arjun1223/SkySafe/THIRD_PARTY_NOTICES.md

# UI component credits

SkySafe adapts two Uiverse components for its monochrome instrument interface:

- **martinval9 — white-lionfish-18**: rectangular toggle used for light/dark theme and automatic load sweep. [Uiverse original](https://uiverse.io/martinval9/white-lionfish-18), [source](https://github.com/uiverse-io/galaxy/blob/main/Toggle-switches/martinval9_white-lionfish-18.html).
- **cssbuttons-io — friendly-dragon-76**: hover/pressed movement adapted for the primary baseline button. The original pill shape and expanding halo are removed. [Uiverse original](https://uiverse.io/cssbuttons-io/friendly-dragon-76), [source](https://github.com/uiverse-io/galaxy/blob/main/Buttons/cssbuttons-io_friendly-dragon-76.html).

Changes include theme variables, keyboard focus, reduced motion support, dimensions and restrained hover effects. The original files and the Uiverse repository license are retained in `docs/uiverse/`.

Copyright (c) 2023 Uiverse.io

Copyright - 2026 martinval9

Copyright - 2026 cssbuttons-io (cssbuttons.io)

Permission is hereby granted, free of charge, to any person obtaining a copy of this software and associated documentation files (the "Software"), to deal in the Software without restriction, including without limitation the rights to use, copy, modify, merge, publish, distribute, sublicense, and/or sell copies of the Software, and to permit persons to whom the Software is furnished to do so, subject to the following conditions:

The above copyright notice and this permission notice shall be included in all copies or substantial portions of the Software.

THE SOFTWARE IS PROVIDED "AS IS", WITHOUT WARRANTY OF ANY KIND, EXPRESS OR IMPLIED, INCLUDING BUT NOT LIMITED TO THE WARRANTIES OF MERCHANTABILITY, FITNESS FOR A PARTICULAR PURPOSE AND NONINFRINGEMENT. IN NO EVENT SHALL THE AUTHORS OR COPYRIGHT HOLDERS BE LIABLE FOR ANY CLAIM, DAMAGES OR OTHER LIABILITY, WHETHER IN AN ACTION OF CONTRACT, TORT OR OTHERWISE, ARISING FROM, OUT OF OR IN CONNECTION WITH THE SOFTWARE OR THE USE OR OTHER DEALINGS IN THE SOFTWARE.

Flask, pyserial, Plotly, Arduino-ESP32, HX711 Arduino Library, and Adafruit sensor libraries retain their respective upstream licenses. They are installed dependencies, not vendored application source. Plotly JavaScript is served locally from its Python package.
