arjun1223/SkySafe/cad/fusion_laptop_stand/previews/load_cell_side_view.png

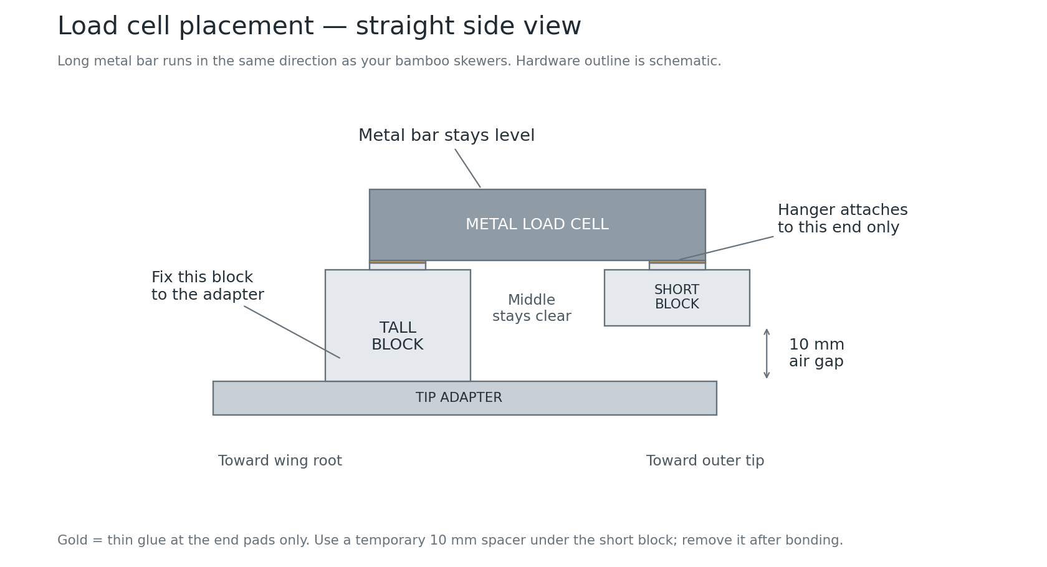
cad/fusion_laptop_stand/previews/load_cell_side_view.png
