arjun1223/SkySafe/cad/fusion_laptop_stand/previews/stand_close.png

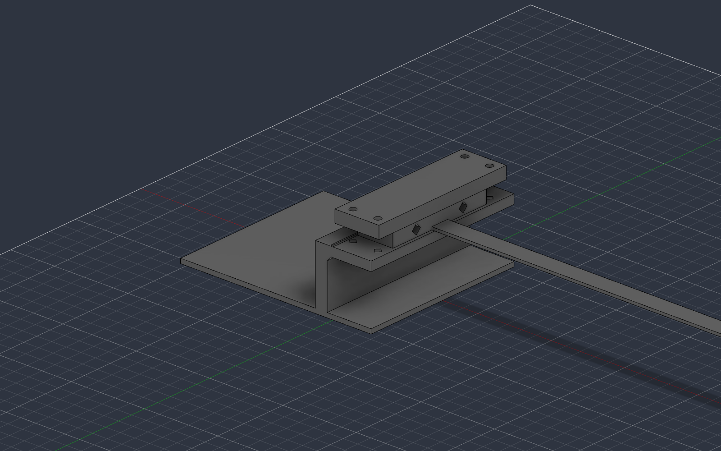
cad/fusion_laptop_stand/previews/stand_close.png
