arjun1223/SkySafe/cad/fusion_laptop_stand/previews/stand_with_wing.png

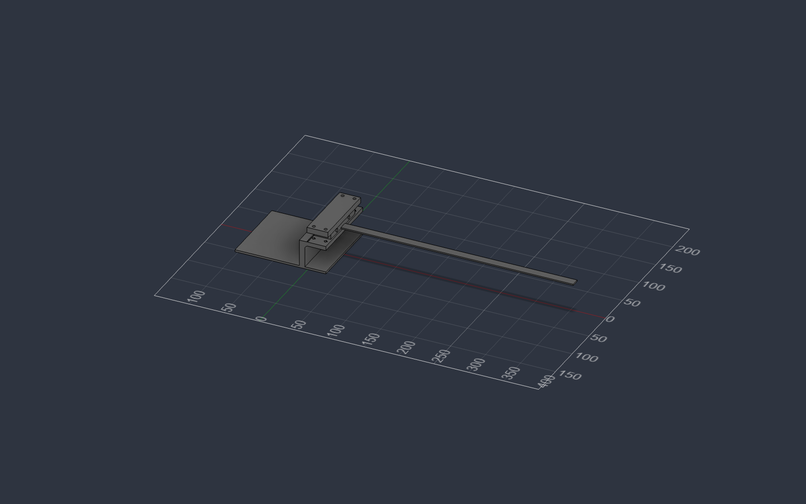
cad/fusion_laptop_stand/previews/stand_with_wing.png
