arjun1223/SkySafe/cad/fusion_laptop_stand/previews/tip_mount_detail.png

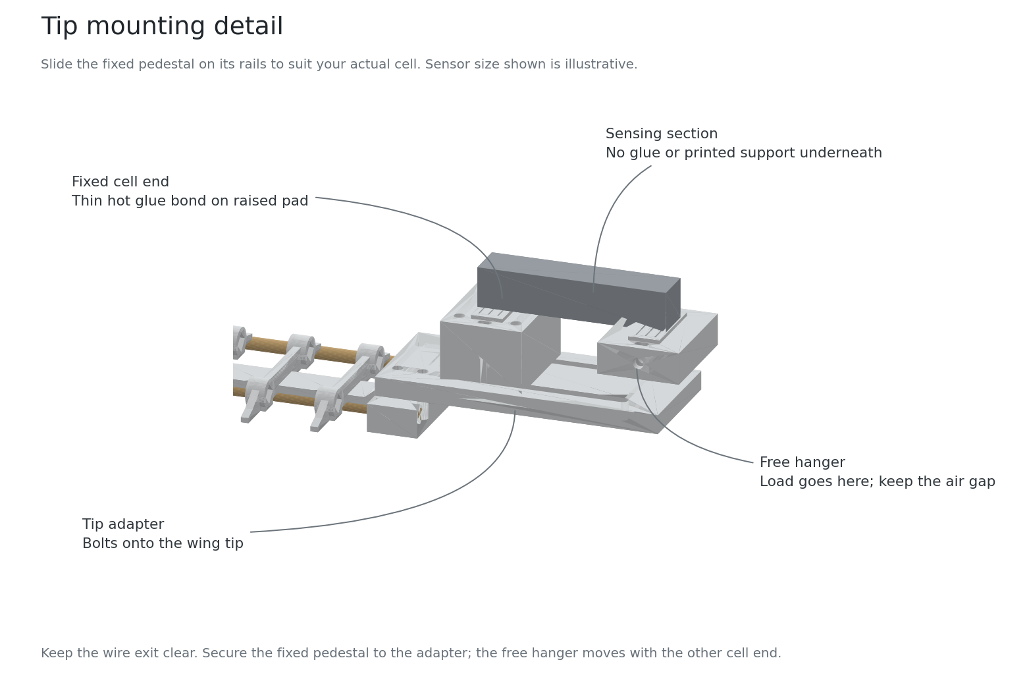
cad/fusion_laptop_stand/previews/tip_mount_detail.png
