arjun1223/SkySafe/cad/previews/exploded.png

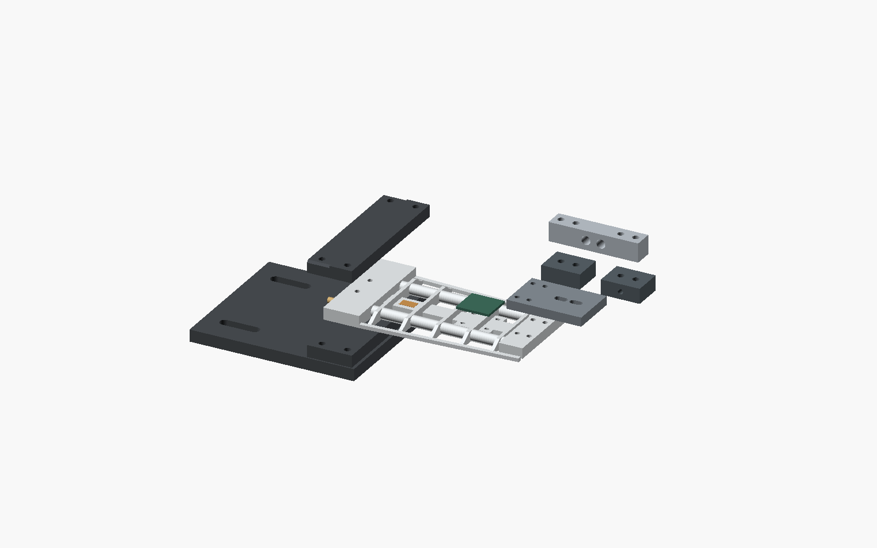
cad/previews/exploded.png
