arjun1223/SkySafe/cad/previews/spar_fit_coupon.png

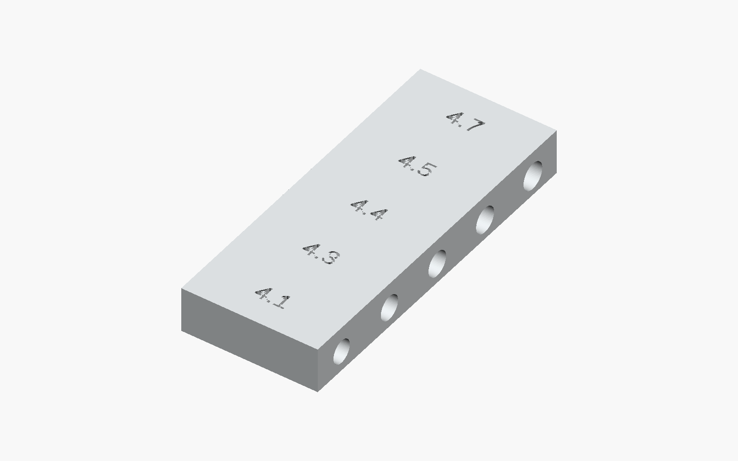
cad/previews/spar_fit_coupon.png
