arjun1223/SkySafe/cad/previews/wing.png

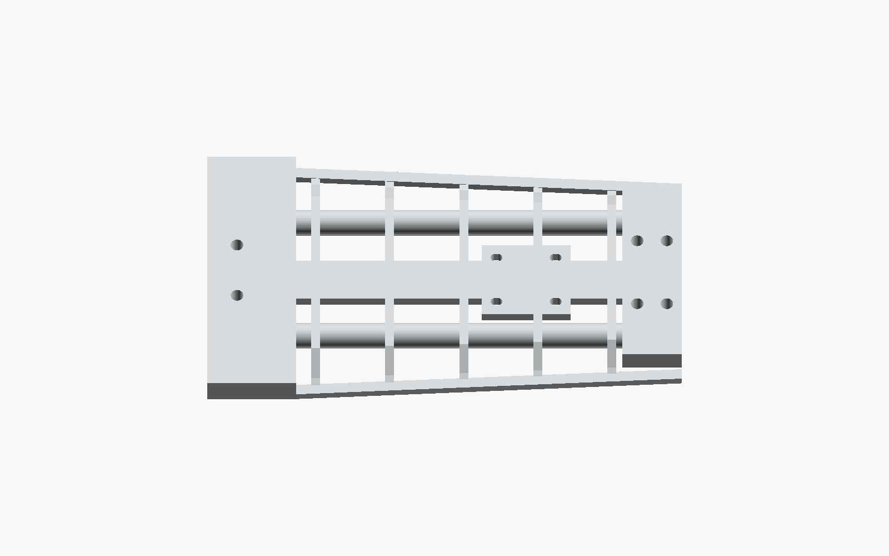
cad/previews/wing.png
