arjun1223/SkySafe/docs/dashboard-dark.png

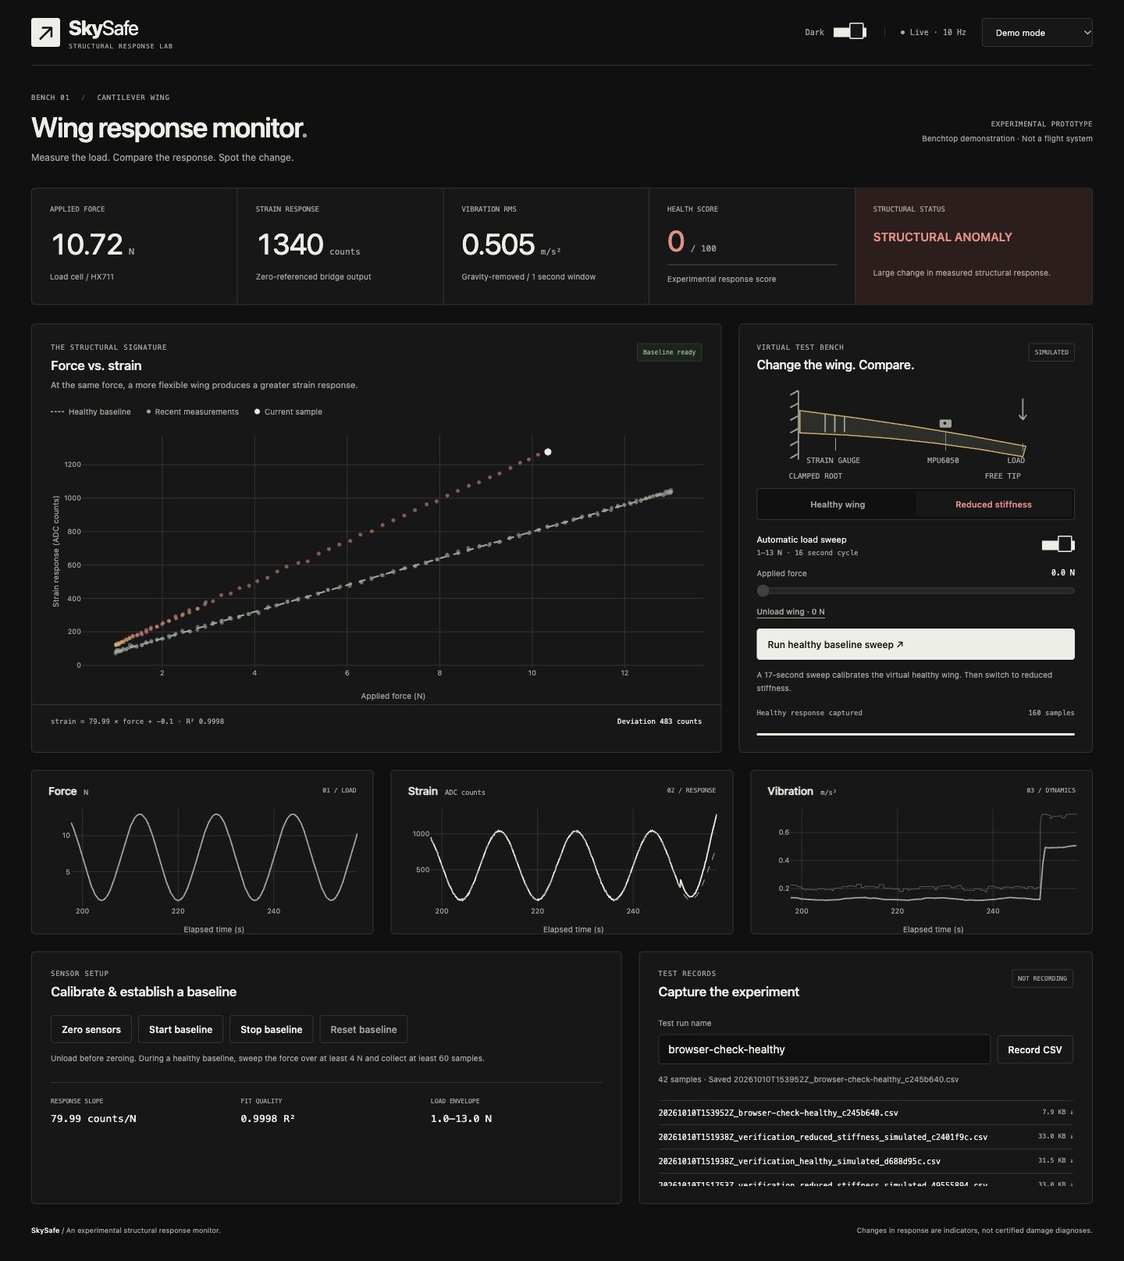
docs/dashboard-dark.png
