arjun1223/SkySafe/docs/dashboard-light.png

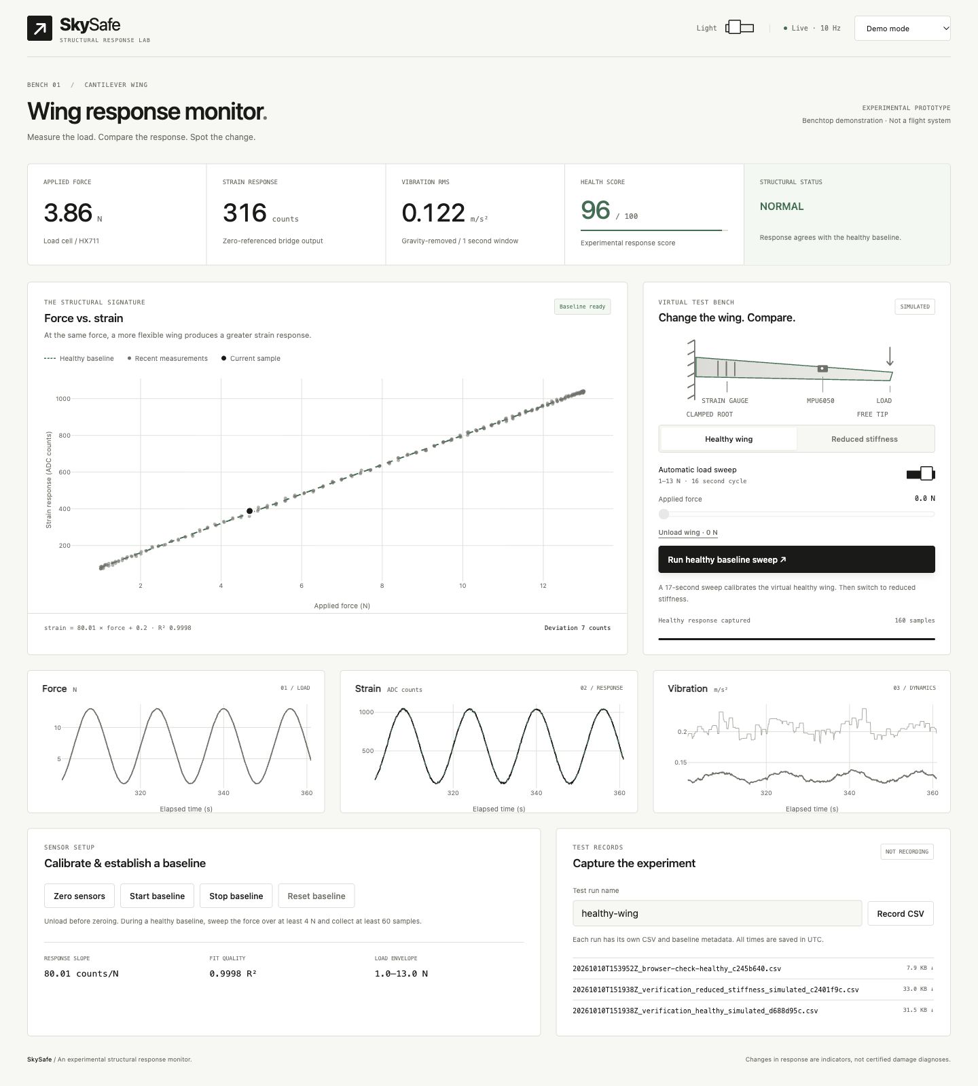
docs/dashboard-light.png
