arjun1223/SkySafe/docs/developer-mode.png

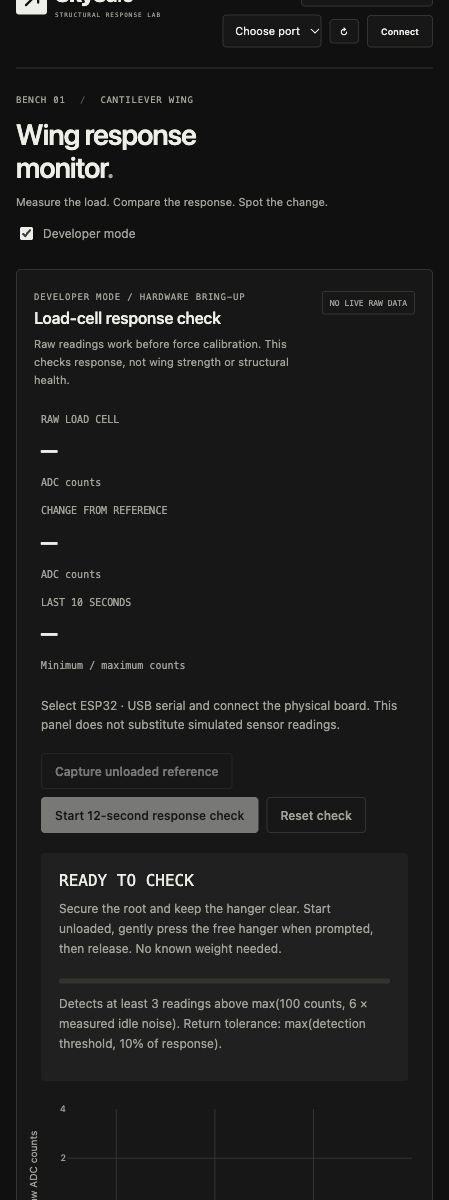
docs/developer-mode.png
