arjun1223/SkySafe/docs/judge-anomaly-dark.png

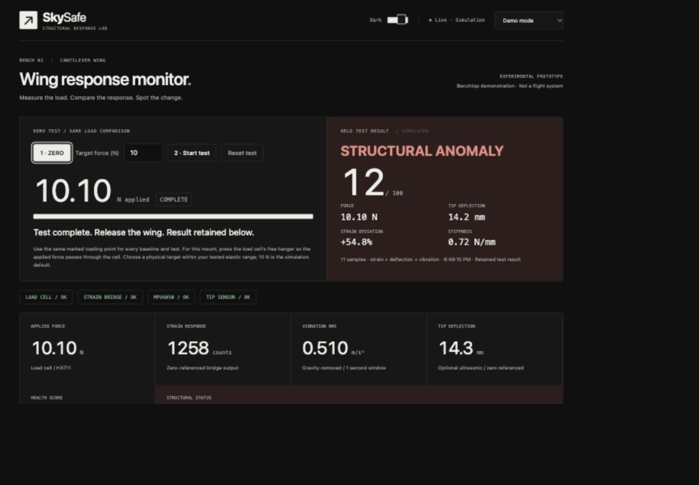
docs/judge-anomaly-dark.png
