arjun1223/SkySafe/docs/judge-healthy-light.png

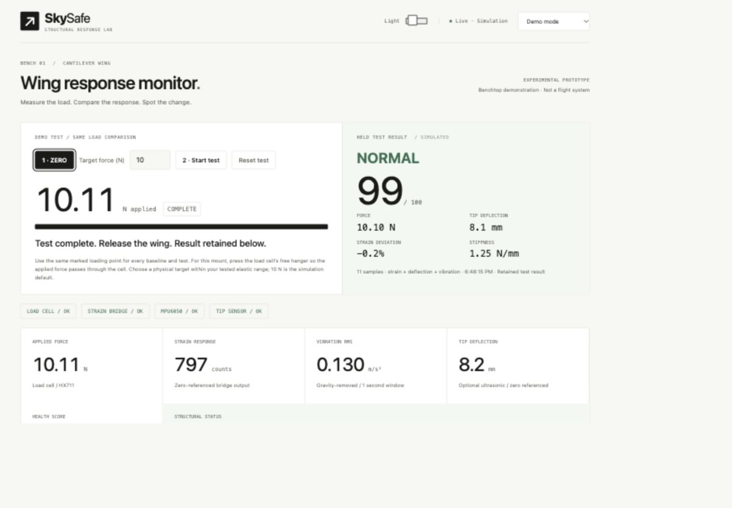
docs/judge-healthy-light.png
