arjun1223/SkySafe/docs/judge-mobile-dark.png

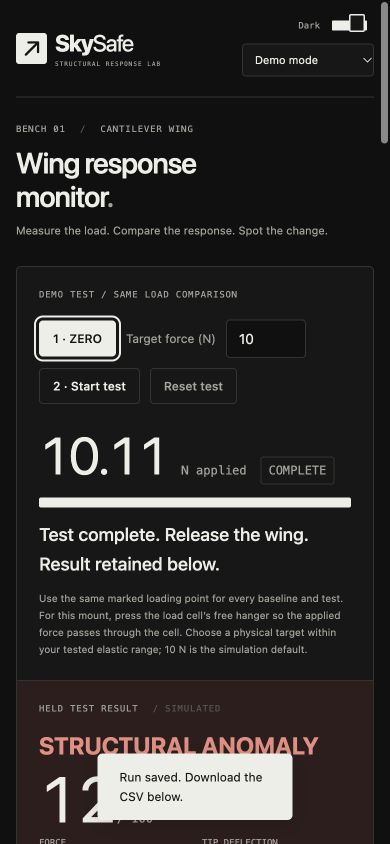
docs/judge-mobile-dark.png
