arjun1223/SkySafe/docs/live-alarm-controls.png

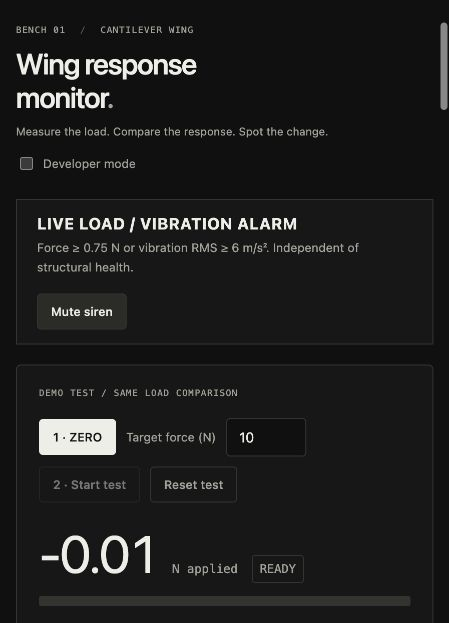
docs/live-alarm-controls.png
