arjun1223/SkySafe/docs/strain-bridge-live.png

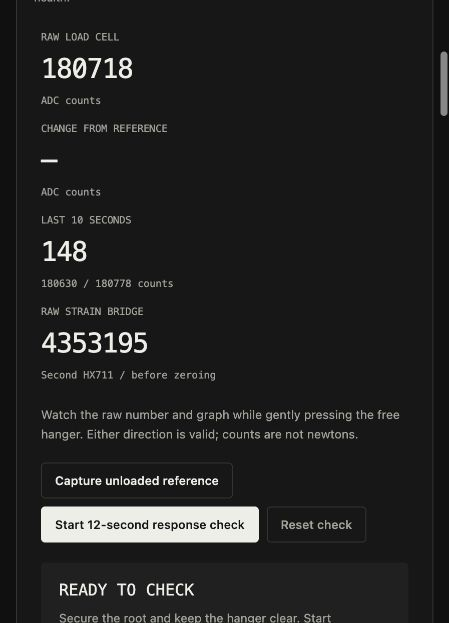
docs/strain-bridge-live.png
