arjun1223/SkySafe/cad/fusion_laptop_stand/previews/your_parts_assembly.png

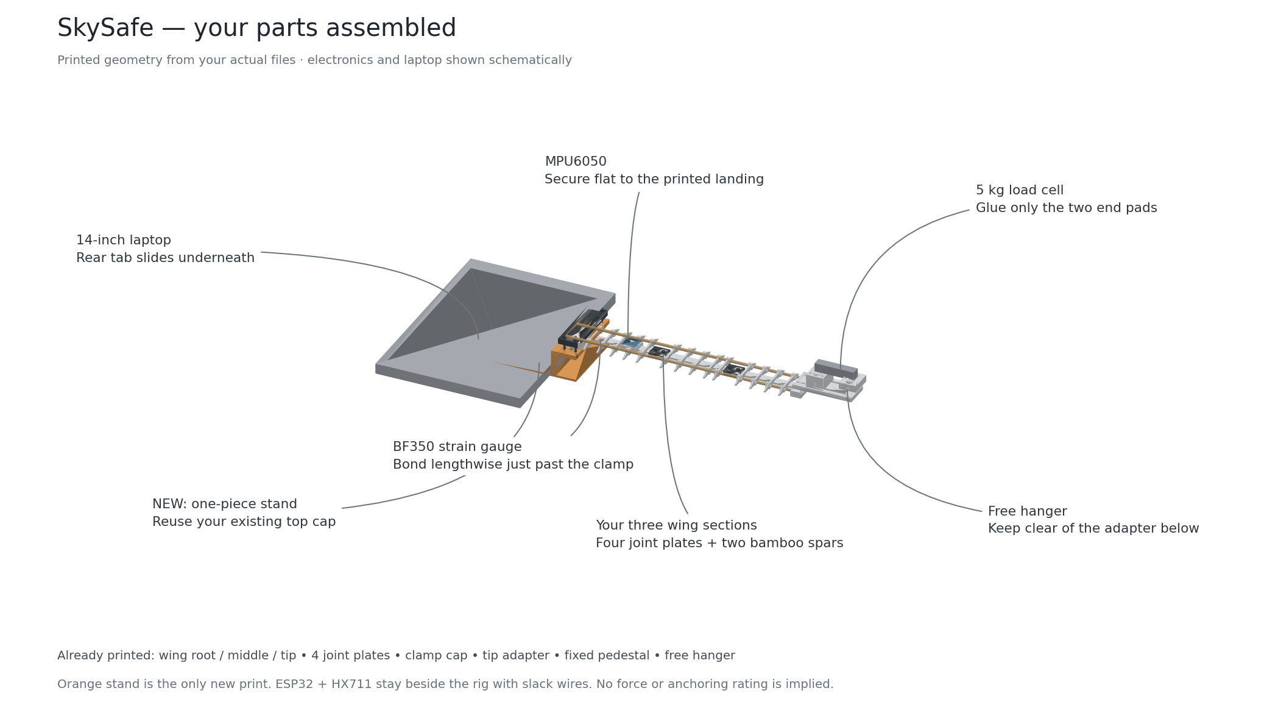
cad/fusion_laptop_stand/previews/your_parts_assembly.png
