arjun1223/SkySafe/cad/fusion/SkySafe_Assembly.step

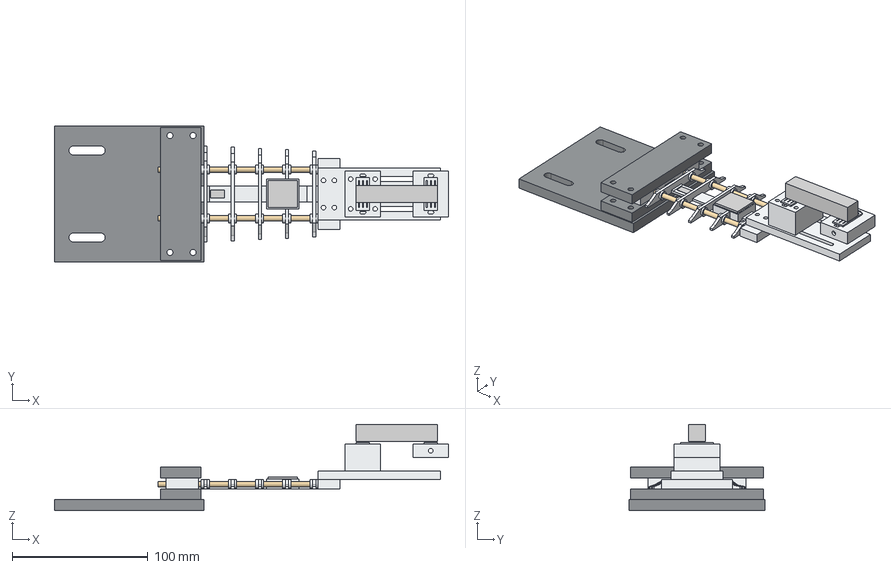
[picture p19: CAD file, 2026-10-11]
cad/fusion/SkySafe_Assembly.step
290.0 x 100.0 x 63.4 mm
