arjun1223/SkySafe/cad/fusion_14inch/SkySafe_Assembly.step

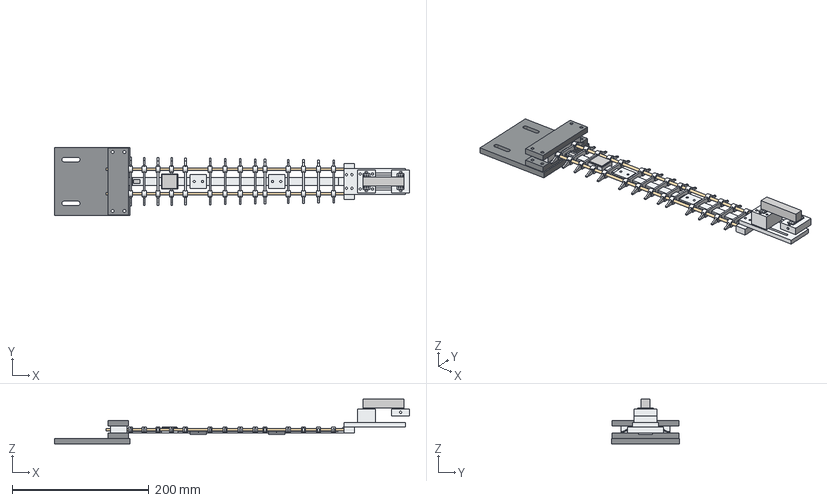
[picture p20: CAD file, 2026-10-11]
cad/fusion_14inch/SkySafe_Assembly.step
518.4 x 100.0 x 65.4 mm
