arjun1223/SkySafe/cad/fusion/step/cell_spacer.step

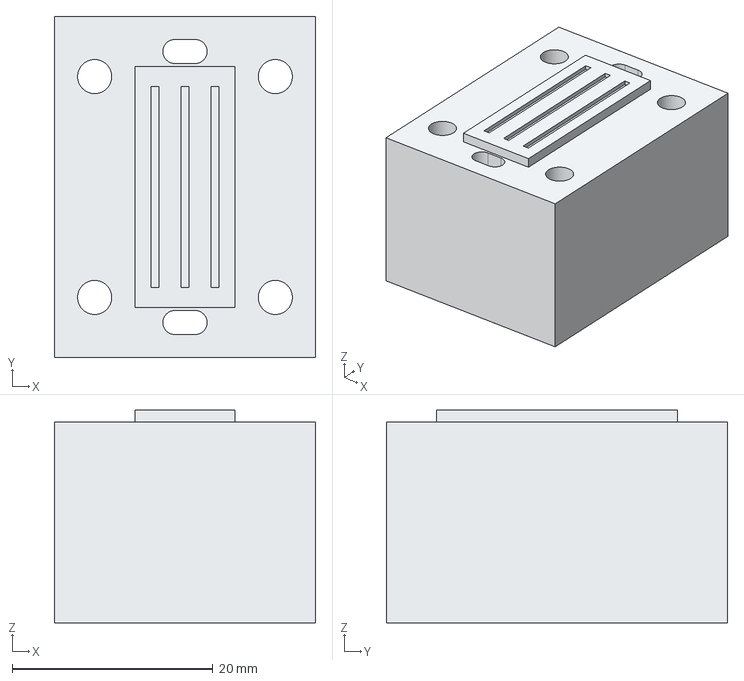
[picture p21: CAD file, 2026-10-11]
cad/fusion/step/cell_spacer.step
26.0 x 34.0 x 21.2 mm
