arjun1223/SkySafe/cad/fusion_14inch/step/spar_fit_coupon.step

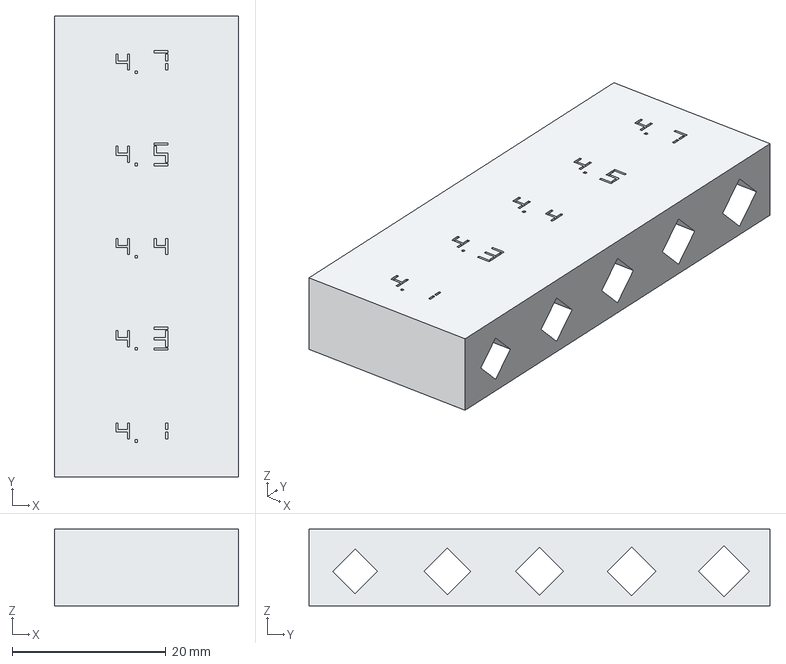
[picture p22: CAD file, 2026-10-11]
cad/fusion_14inch/step/spar_fit_coupon.step
24.0 x 60.0 x 10.0 mm
