arjun1223/SkySafe/cad/fusion_laptop_stand/SkySafe_Laptop_Stand.step

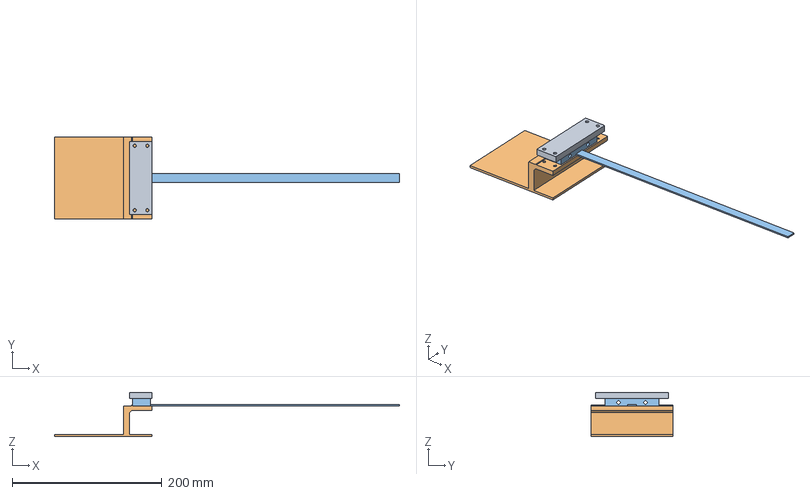
[picture p23: CAD file, 2026-10-11]
cad/fusion_laptop_stand/SkySafe_Laptop_Stand.step
460.4 x 110.0 x 59.0 mm
