arjun1223/SkySafe/cad/fusion_laptop_stand/step/laptop_foot_stand.step

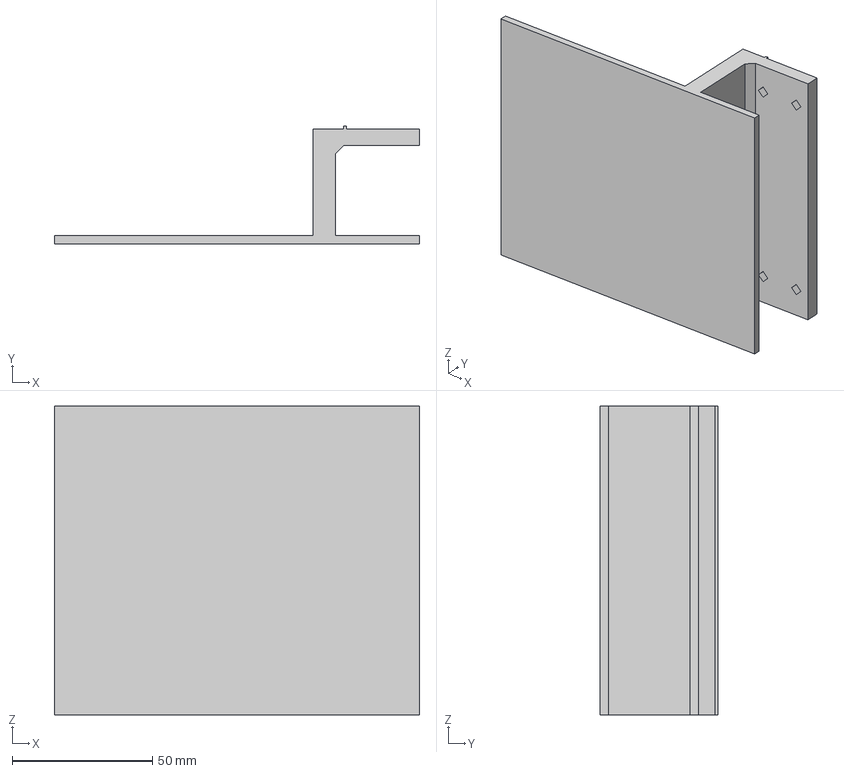
[picture p24: CAD file, 2026-10-11]
cad/fusion_laptop_stand/step/laptop_foot_stand.step
130.0 x 42.0 x 110.0 mm
