arjun1223/SkySafe/cad/fusion_weighted/SkySafe_Weighted_Holder.step

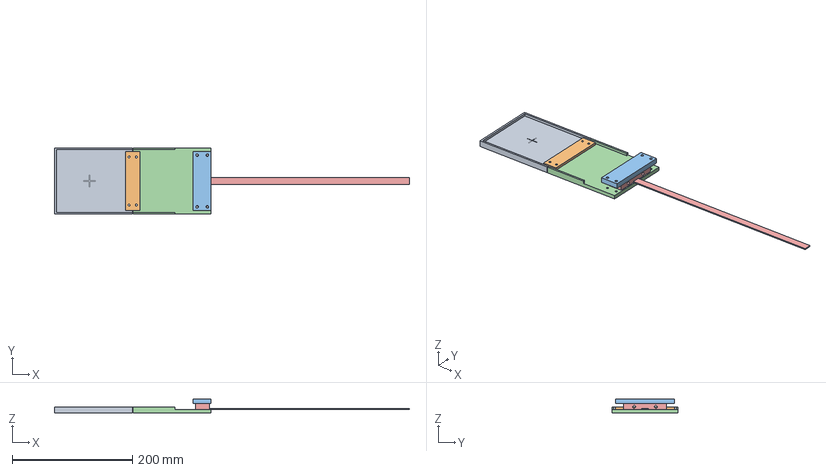
[picture p25: CAD file, 2026-10-11]
cad/fusion_weighted/SkySafe_Weighted_Holder.step
590.6 x 110.0 x 24.0 mm
