arjun1223/SkySafe/cad/fusion_weighted/step/tray_bridge.step

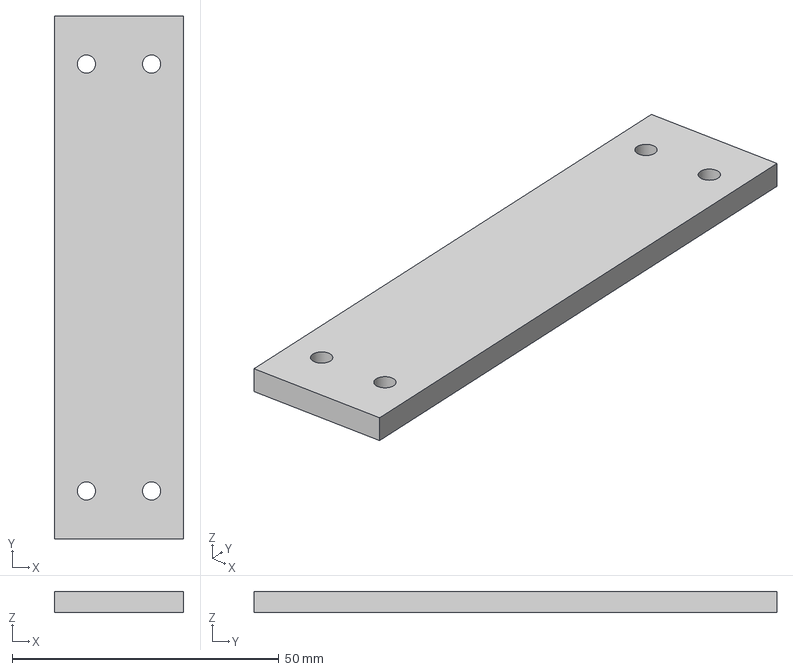
[picture p26: CAD file, 2026-10-11]
cad/fusion_weighted/step/tray_bridge.step
24.2 x 98.0 x 4.00 mm
