arjun1223/SkySafe/cad/stl/cell_spacer.stl

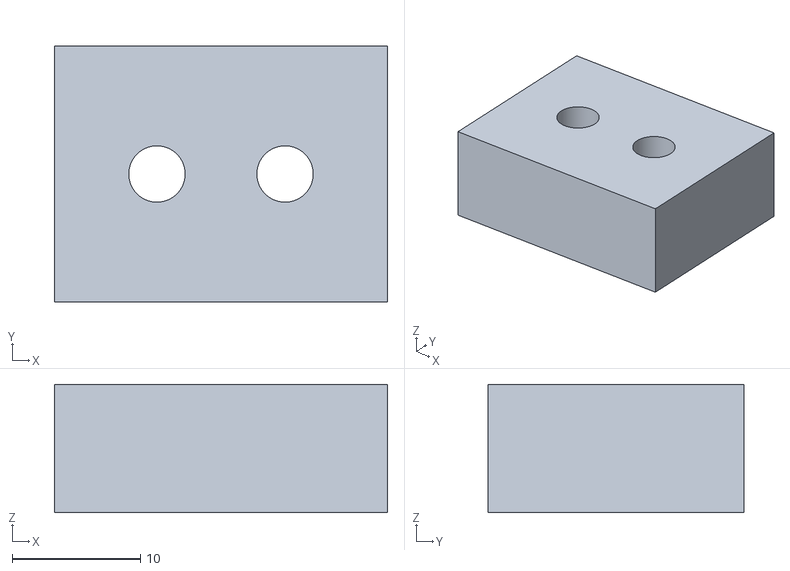
[picture p27: CAD file, 2026-10-11]
cad/stl/cell_spacer.stl
26.0 x 20.0 x 10.0
