arjun1223/SkySafe/cad/fusion/step/wing.step

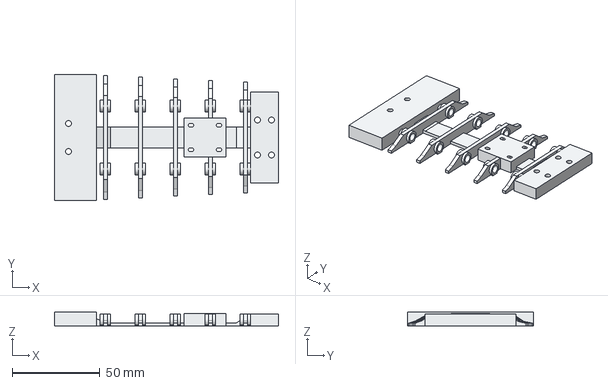
[picture p28: CAD file, 2026-10-11]
cad/fusion/step/wing.step
128.0 x 72.0 x 8.00 mm
