arjun1223/SkySafe/cad/fusion_14inch/step/root_cap.step

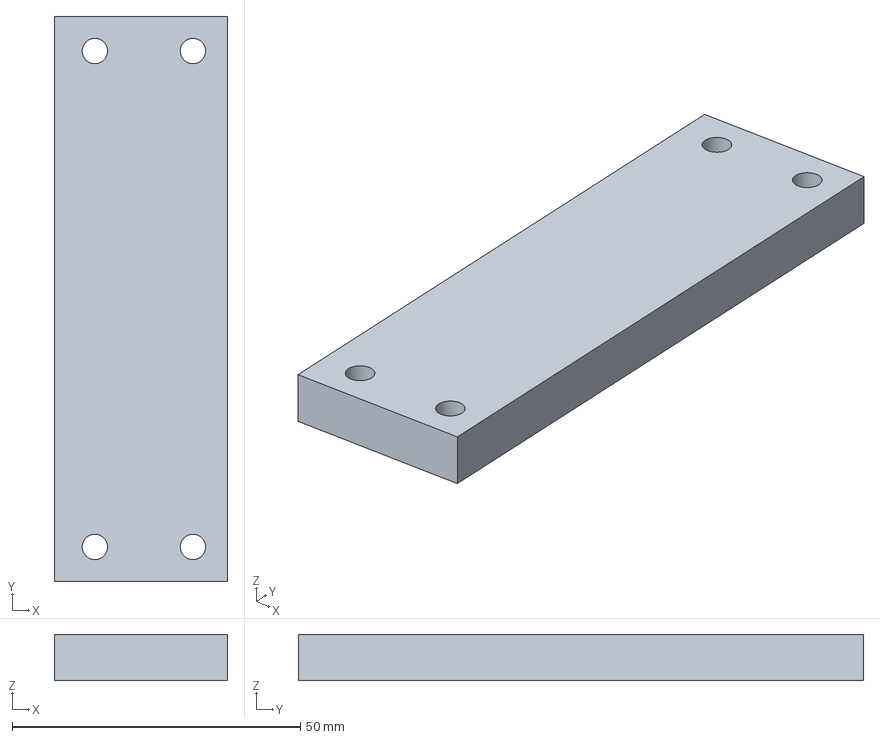
[picture p29: CAD file, 2026-10-11]
cad/fusion_14inch/step/root_cap.step
30.0 x 98.0 x 8.00 mm
