arjun1223/SkySafe/cad/fusion_weighted/step/ballast_tray.step

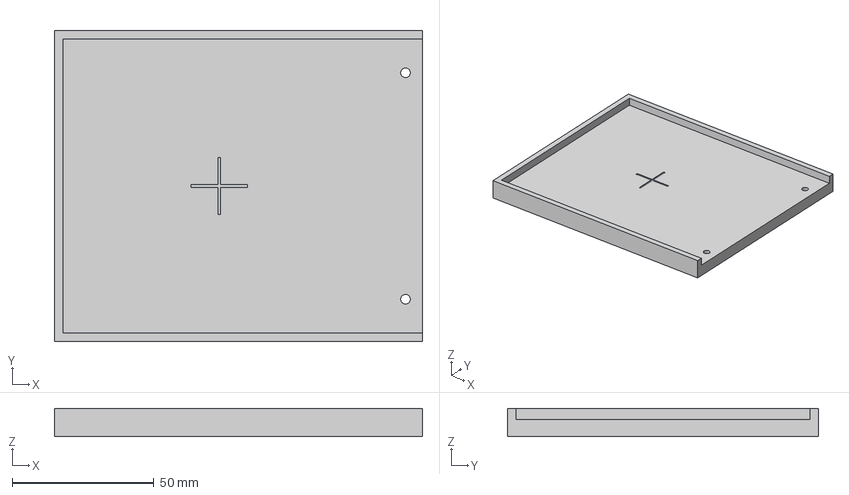
[picture p30: CAD file, 2026-10-11]
cad/fusion_weighted/step/ballast_tray.step
130.0 x 110.0 x 10.0 mm
