arjun1223/SkySafe/cad/stl/spar_fit_coupon.stl

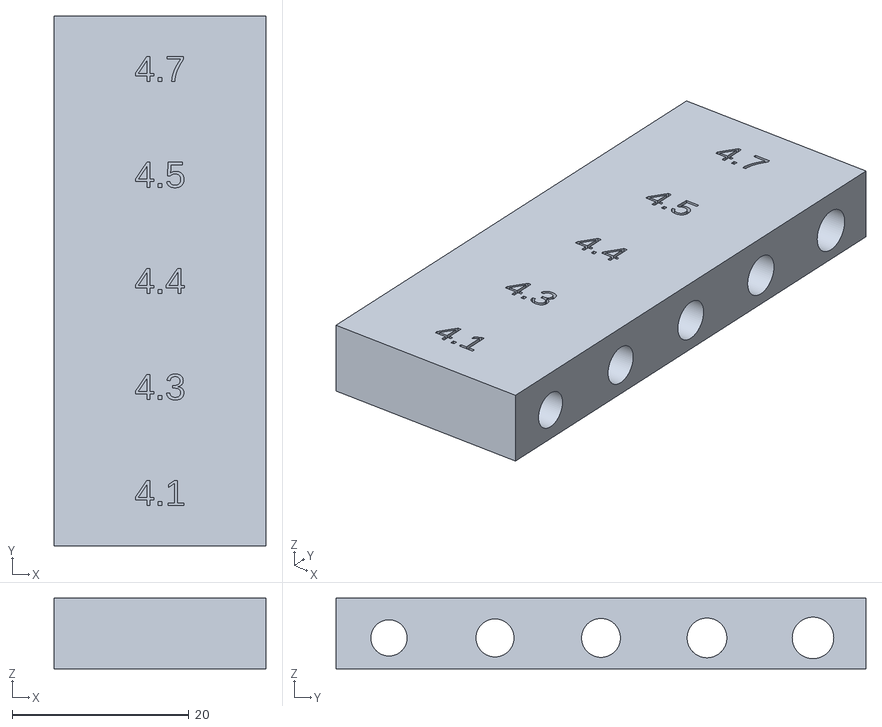
[picture p31: CAD file, 2026-10-11]
cad/stl/spar_fit_coupon.stl
24.0 x 60.0 x 8.00
