arjun1223/SkySafe/cad/fusion_14inch/step/wing_tip.step

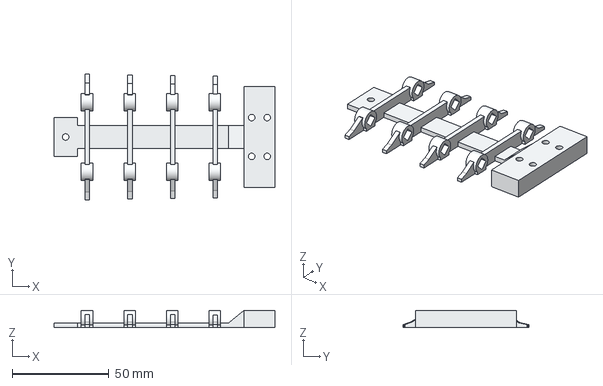
[picture p32: CAD file, 2026-10-11]
cad/fusion_14inch/step/wing_tip.step
114.0 x 64.7 x 9.00 mm
