arjun1223/SkySafe/cad/fusion_weighted/step/weighted_root_base.step

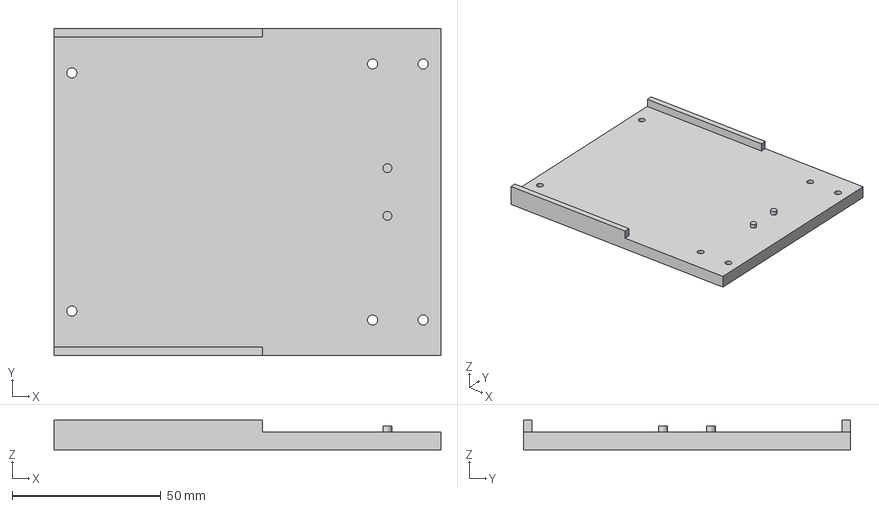
[picture p33: CAD file, 2026-10-11]
cad/fusion_weighted/step/weighted_root_base.step
130.0 x 110.0 x 10.0 mm
