arjun1223/SkySafe/cad/stl/load_hanger.stl

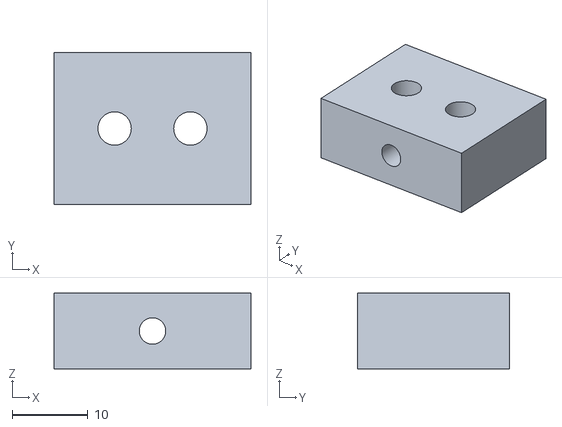
[picture p34: CAD file, 2026-10-11]
cad/stl/load_hanger.stl
26.0 x 20.0 x 10.0
