arjun1223/SkySafe/cad/fusion/step/load_hanger.step

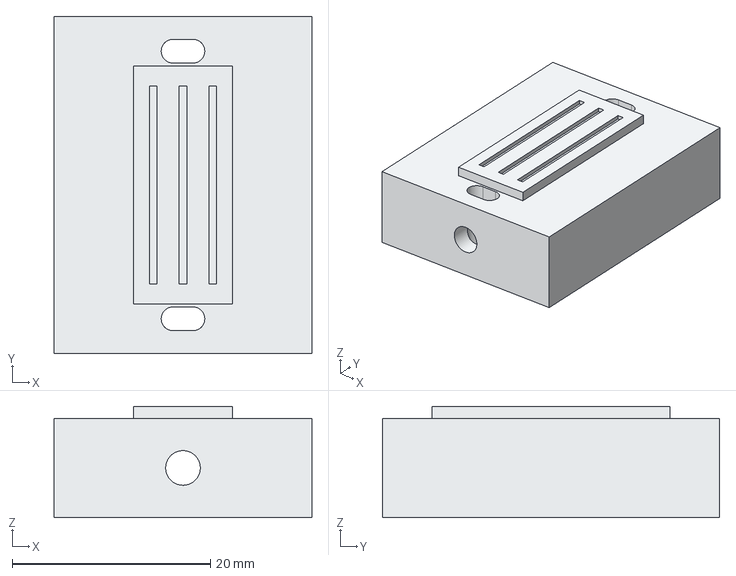
[picture p35: CAD file, 2026-10-11]
cad/fusion/step/load_hanger.step
26.0 x 34.0 x 11.2 mm
