arjun1223/SkySafe/cad/fusion_14inch/step/joint_plate.step

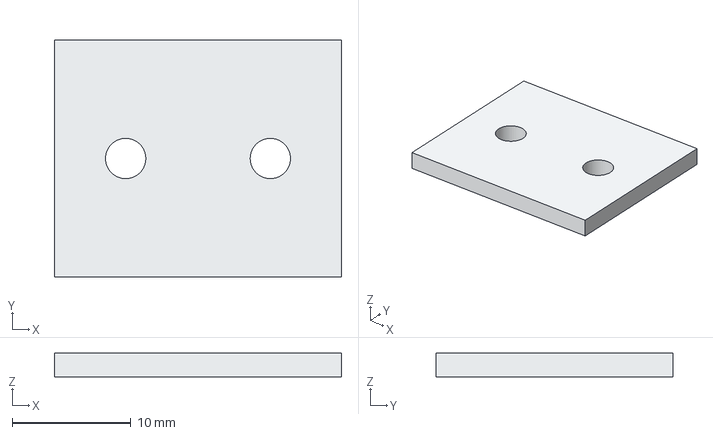
[picture p36: CAD file, 2026-10-11]
cad/fusion_14inch/step/joint_plate.step
24.2 x 20.0 x 2.00 mm
