arjun1223/SkySafe/cad/stl/tip_adapter.stl

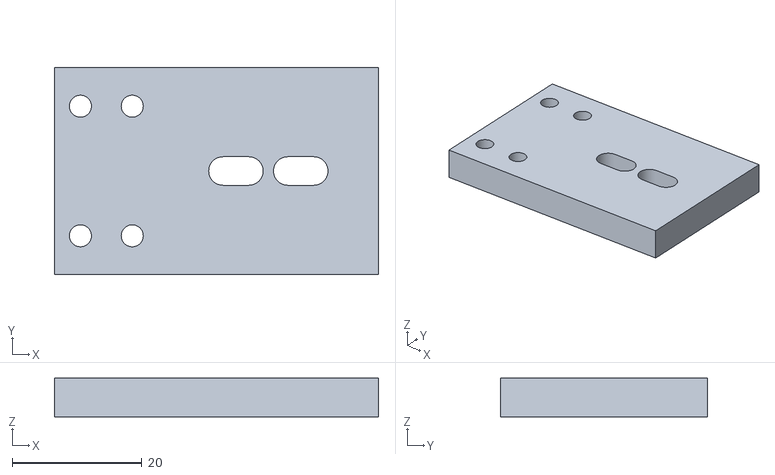
[picture p37: CAD file, 2026-10-11]
cad/stl/tip_adapter.stl
50.0 x 32.0 x 6.00
