arjun1223/SkySafe/cad/fusion/step/tip_adapter.step

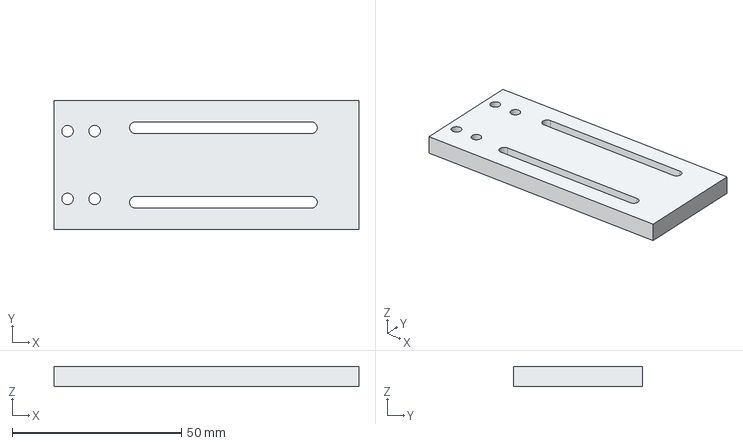
[picture p38: CAD file, 2026-10-11]
cad/fusion/step/tip_adapter.step
90.0 x 38.0 x 6.00 mm
