arjun1223/SkySafe/cad/fusion_14inch/step/wing_root.step

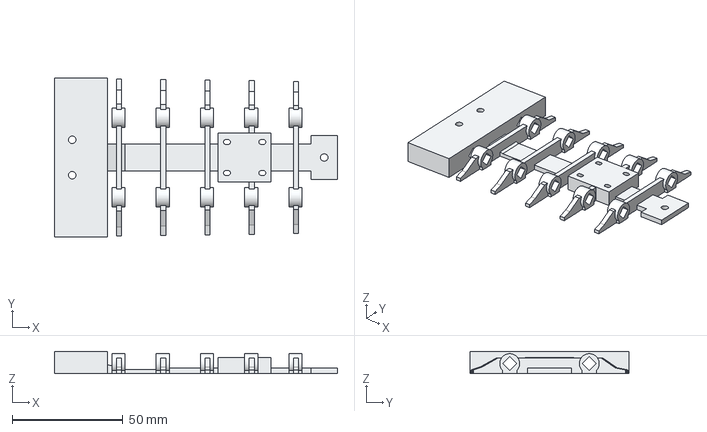
[picture p39: CAD file, 2026-10-11]
cad/fusion_14inch/step/wing_root.step
128.0 x 72.0 x 10.0 mm
