arjun1223/SkySafe/cad/stl/wing.stl

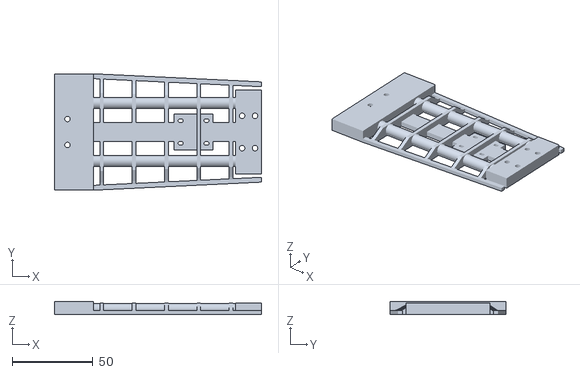
[picture p40: CAD file, 2026-10-11]
cad/stl/wing.stl
128.0 x 72.0 x 8.00
