arjun1223/SkySafe/cad/fusion/step/root_base.step

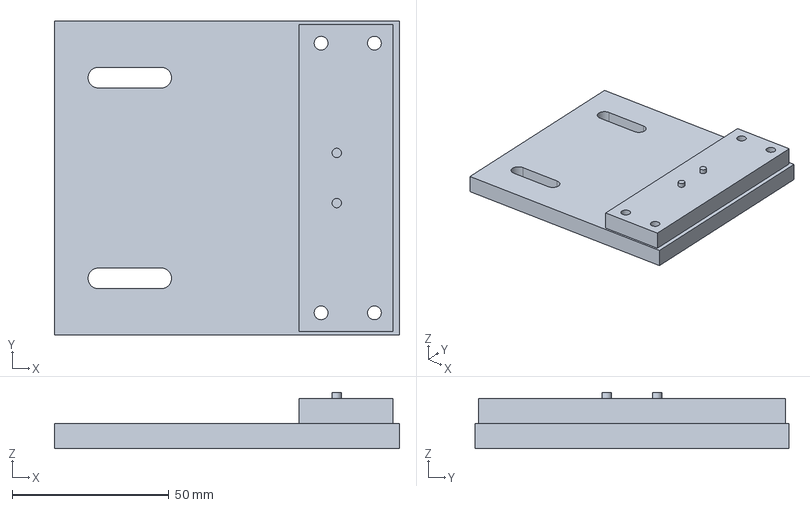
[picture p41: CAD file, 2026-10-11]
cad/fusion/step/root_base.step
110.0 x 100.0 x 18.0 mm
