arjun1223/SkySafe/cad/fusion_14inch/step/wing_middle.step

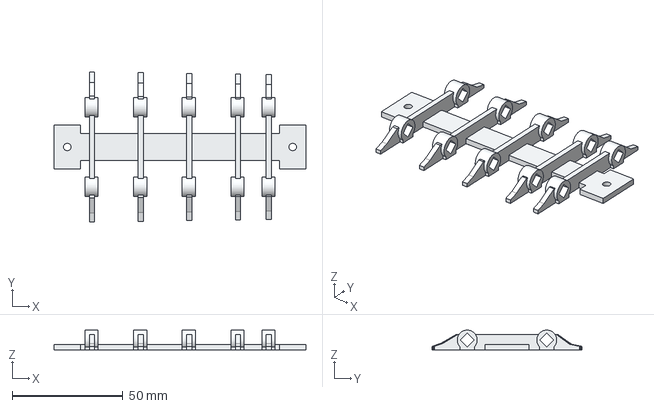
[picture p42: CAD file, 2026-10-11]
cad/fusion_14inch/step/wing_middle.step
114.0 x 68.0 x 9.00 mm
