arjun1223/SkySafe/(list of files, cad)

Other CAD files:
cad/fusion/step/spar_fit_coupon.step
cad/fusion_14inch/step/tip_adapter.step
cad/stl/root_base.stl
cad/fusion/step/root_cap.step
cad/fusion_14inch/step/load_hanger.step
cad/stl/root_cap.stl
cad/fusion_14inch/step/cell_spacer.step
cad/fusion_14inch/step/root_base.step
cad/fusion/SkySafe_Assembly.f3d
cad/fusion/SkySafe_PrintParts.f3d
cad/fusion/cell_spacer.f3d
cad/fusion/load_hanger.f3d
cad/fusion/root_base.f3d
cad/fusion/root_cap.f3d
cad/fusion/spar_fit_coupon.f3d
cad/fusion/stl/cell_spacer.stl
cad/fusion/stl/load_hanger.stl
cad/fusion/stl/root_base.stl
cad/fusion/stl/root_cap.stl
cad/fusion/stl/spar_fit_coupon.stl
cad/fusion/stl/tip_adapter.stl
cad/fusion/stl/wing.stl
cad/fusion/tip_adapter.f3d
cad/fusion/wing.f3d
cad/fusion_14inch/SkySafe_Assembly.f3d
cad/fusion_14inch/SkySafe_PrintParts.f3d
cad/fusion_14inch/cell_spacer.f3d
cad/fusion_14inch/joint_plate.f3d
cad/fusion_14inch/load_hanger.f3d
cad/fusion_14inch/root_base.f3d
cad/fusion_14inch/root_cap.f3d
cad/fusion_14inch/spar_fit_coupon.f3d
cad/fusion_14inch/stl/cell_spacer.stl
cad/fusion_14inch/stl/joint_plate.stl
cad/fusion_14inch/stl/load_hanger.stl
cad/fusion_14inch/stl/root_base.stl
cad/fusion_14inch/stl/root_cap.stl
cad/fusion_14inch/stl/spar_fit_coupon.stl
cad/fusion_14inch/stl/tip_adapter.stl
cad/fusion_14inch/stl/wing_middle.stl
cad/fusion_14inch/stl/wing_root.stl
cad/fusion_14inch/stl/wing_tip.stl
cad/fusion_14inch/tip_adapter.f3d
cad/fusion_14inch/wing_middle.f3d
cad/fusion_14inch/wing_root.f3d
cad/fusion_14inch/wing_tip.f3d
cad/fusion_laptop_stand/SkySafe_Laptop_Stand.f3d
cad/fusion_laptop_stand/laptop_foot_stand.f3d
cad/fusion_laptop_stand/stl/laptop_foot_stand.stl
cad/fusion_weighted/SkySafe_Weighted_Holder.f3d
cad/fusion_weighted/ballast_tray.f3d
cad/fusion_weighted/stl/ballast_tray.stl
cad/fusion_weighted/stl/tray_bridge.stl
cad/fusion_weighted/stl/weighted_root_base.stl
cad/fusion_weighted/tray_bridge.f3d
cad/fusion_weighted/weighted_root_base.f3d
