arjun1223/SkySafe/cad/fusion_14inch/previews/fusion_assembly.png

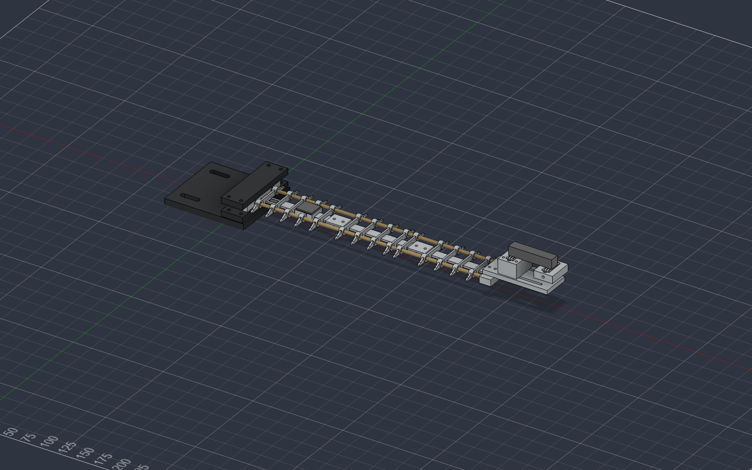
cad/fusion_14inch/previews/fusion_assembly.png
