arjun1223/SkySafe/cad/fusion_weighted/previews/weighted_assembly.png

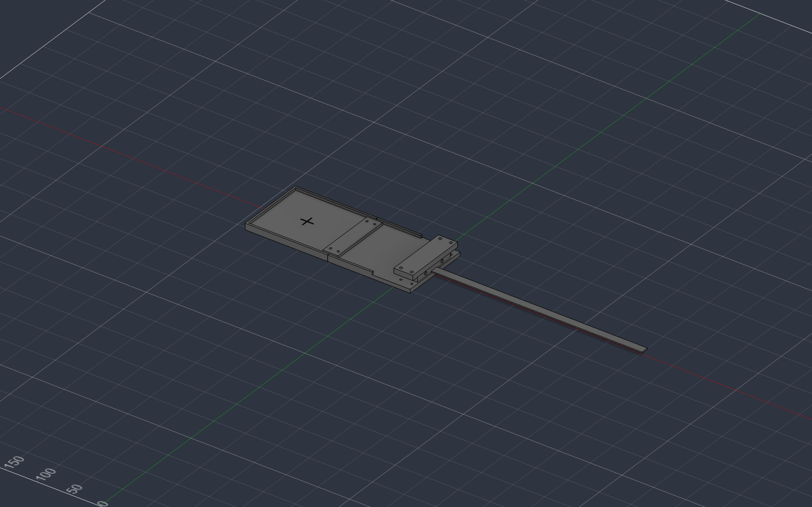
cad/fusion_weighted/previews/weighted_assembly.png
