arjun1223/SkySafe/cad/previews/assembly.png

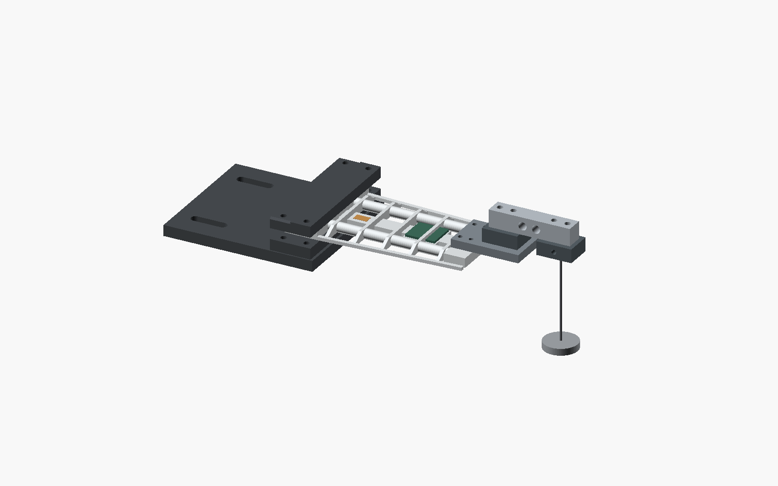
cad/previews/assembly.png
