arjun1223/SkySafe/(commit log)

2026-10-11 Publish SkySafe dashboard, ESP32 firmware, Fusion CAD and assembly guides
    [SkySafe.scad, SkySafe_Assembly.f3d, SkySafe_Assembly.step, SkySafe_Laptop_Stand.f3d, SkySafe_Laptop_Stand.step, SkySafe_PrintParts.f3d, SkySafe_Weighted_Holder.f3d, SkySafe_Weighted_Holder.step]
2026-10-11 Add independent 0.75 N load and 6 m/s2 vibration siren alerts
    [config.py, engine.py]
